robinned/cpe350-astromech-board/README.md

# cpe350-astromech-board
Main control board design for Cal Poly Robotics' astromech, Pascal. Designed by CPE350 Naboo Networks team.
