robinned/cpe350-astromech-board/3d/PCF8575PWR.step

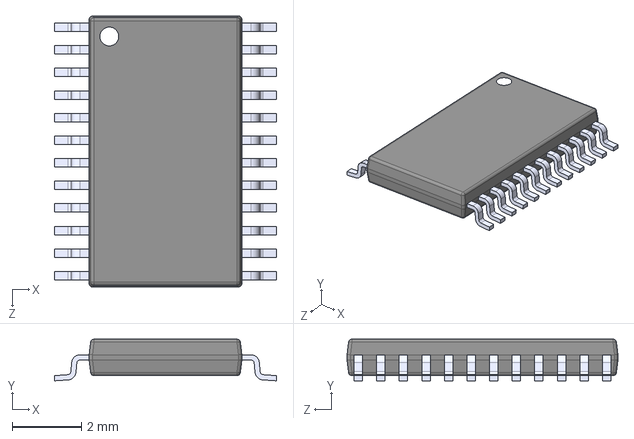
[picture p1: CAD file, 2025-02-07]
3d/PCF8575PWR.step
6.40 x 1.20 x 7.80 mm
