robinned/cpe350-astromech-board/LS7366R/LS7366R.step

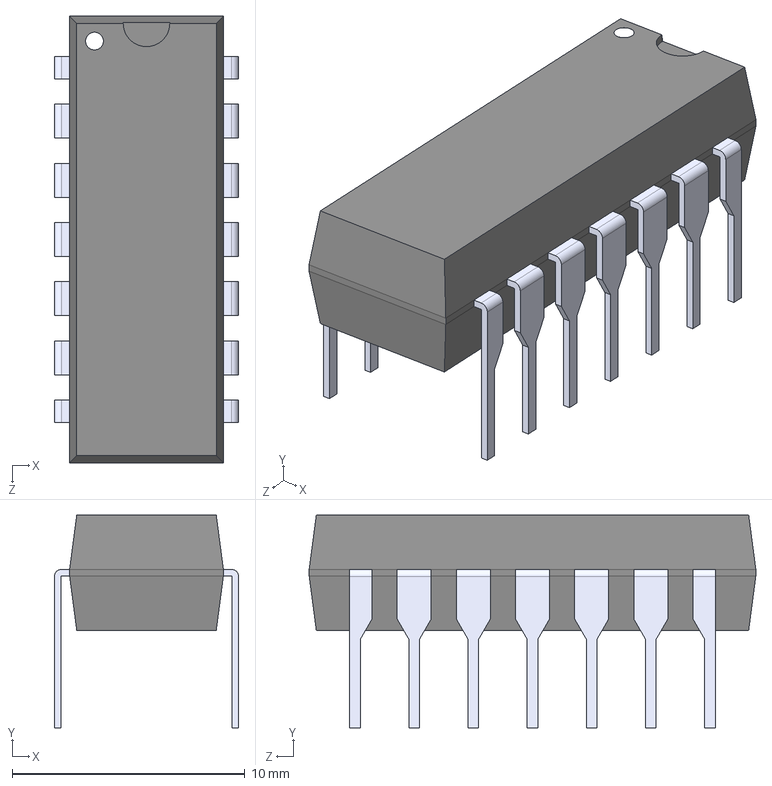
[picture p2: CAD file, 2024-11-14]
LS7366R/LS7366R.step
7.90 x 9.14 x 19.2 mm
