robinned/cpe350-astromech-board/3d/SC16IS752IPW_128.step

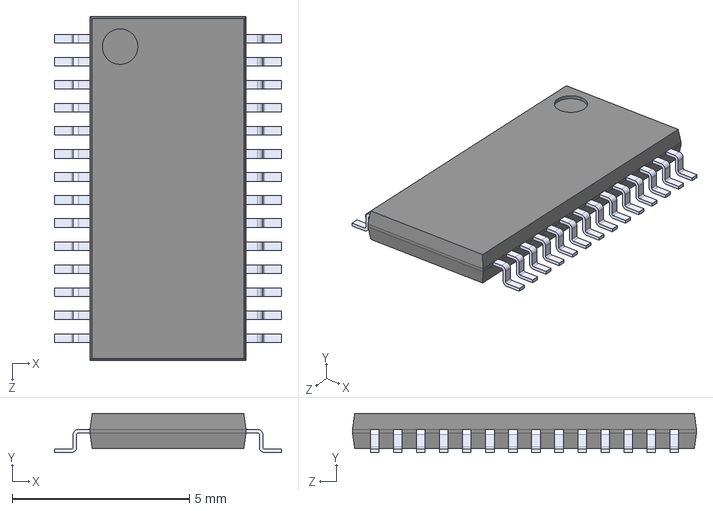
[picture p3: CAD file, 2025-02-04]
3d/SC16IS752IPW_128.step
6.40 x 1.10 x 9.70 mm
