robinned/cpe350-astromech-board/3d/SN74HC14DR.step

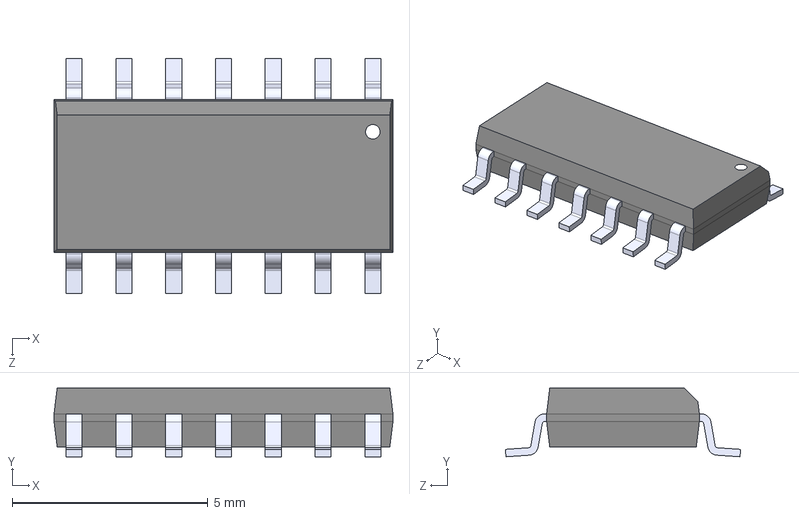
[picture p4: CAD file, 2025-01-31]
3d/SN74HC14DR.step
8.65 x 1.75 x 6.00 mm
