robinned/cpe350-astromech-board/3d/TBL009V-254-16GY-2GY.step

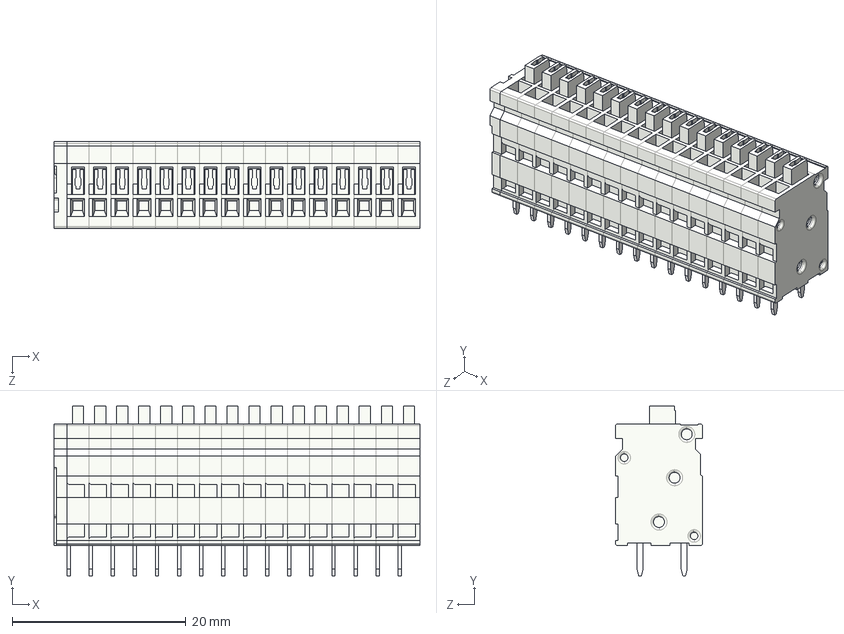
[picture p5: CAD file, 2025-01-31]
3d/TBL009V-254-16GY-2GY.step
42.1 x 19.6 x 10.0 mm
TBL009V-254 - END CAP_Gray
TBL009V-254 - BODY_Gray x 16
TBL009V-254 - PUSH BUTTON_Gray x 16
