robinned/cpe350-astromech-board/3d/691210910005.step

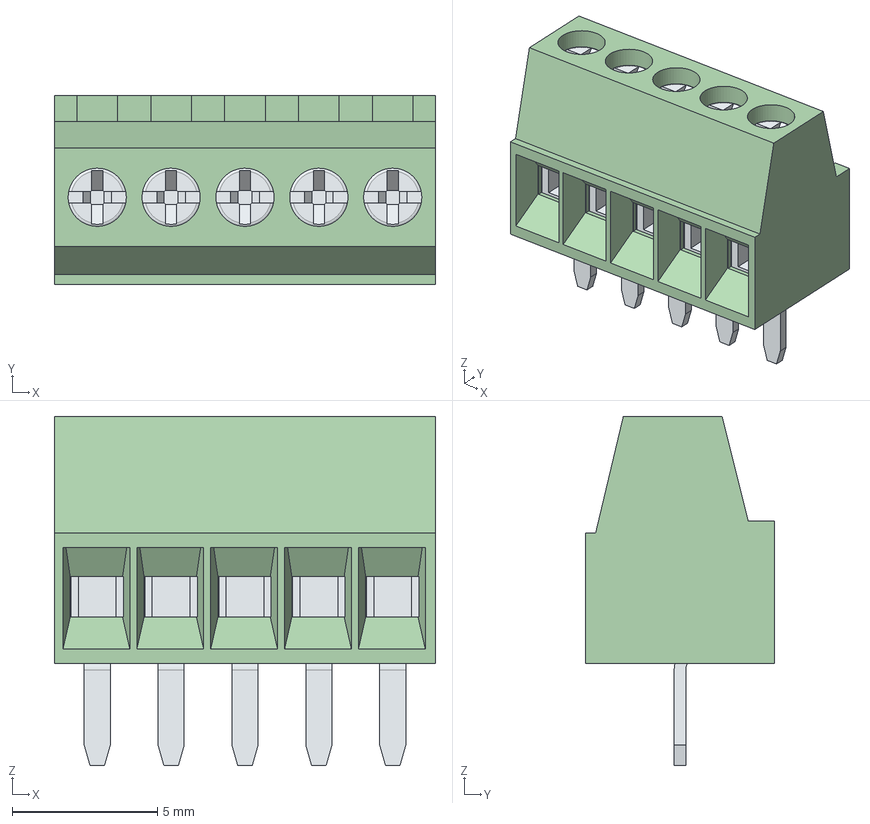
[picture p6: CAD file, 2025-01-31]
3d/691210910005.step
13.1 x 6.50 x 12.0 mm
6912109100xx_CAGE x 5
6912109100xx_PIN x 5
6912109100xx_VIS x 5
