robinned/cpe350-astromech-board/3d/691210910004.step

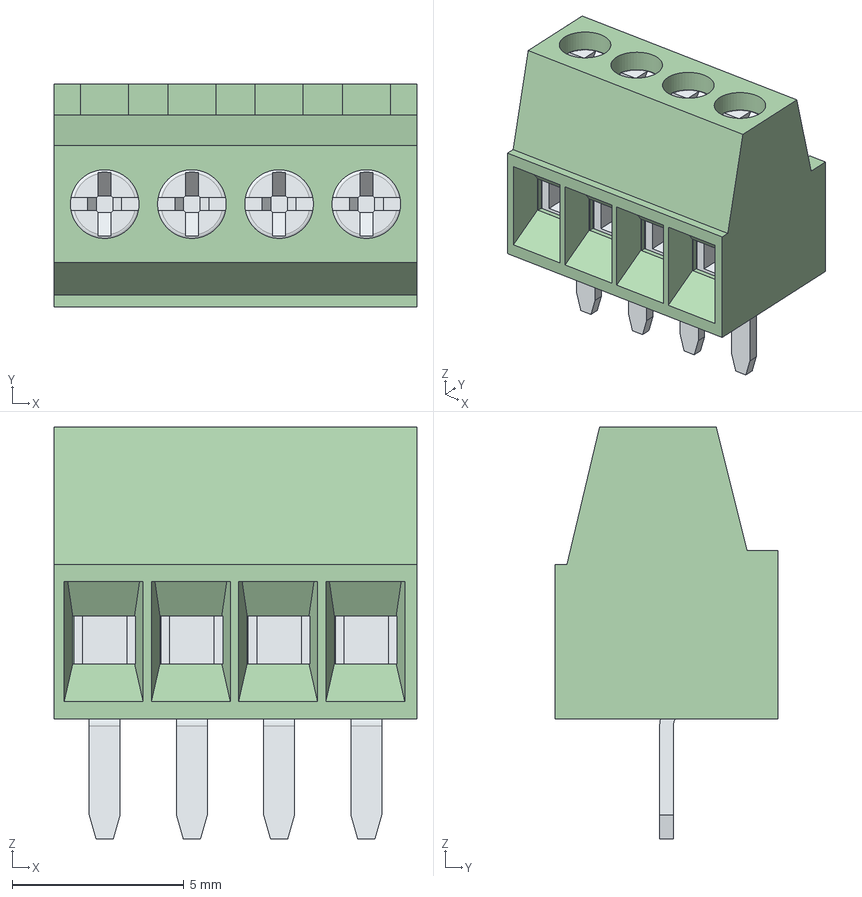
[picture p7: CAD file, 2025-01-31]
3d/691210910004.step
10.6 x 6.50 x 12.0 mm
6912109100xx_CAGE x 4
6912109100xx_PIN x 4
6912109100xx_VIS x 4
