robinned/cpe350-astromech-board/3d/1984617.step

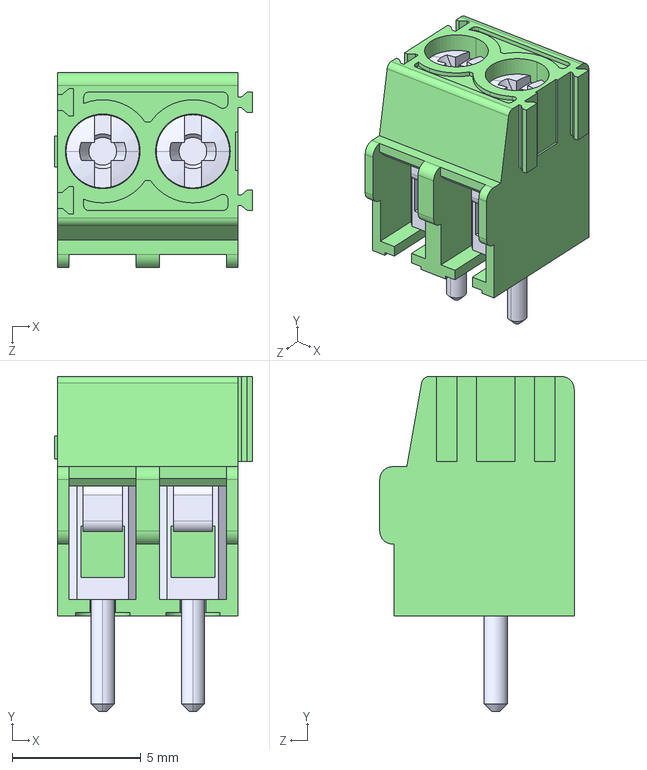
[picture p8: CAD file, 2025-01-31]
3d/1984617.step
7.70 x 13.0 x 7.55 mm
