robinned/cpe350-astromech-board/3d/691210910006.step

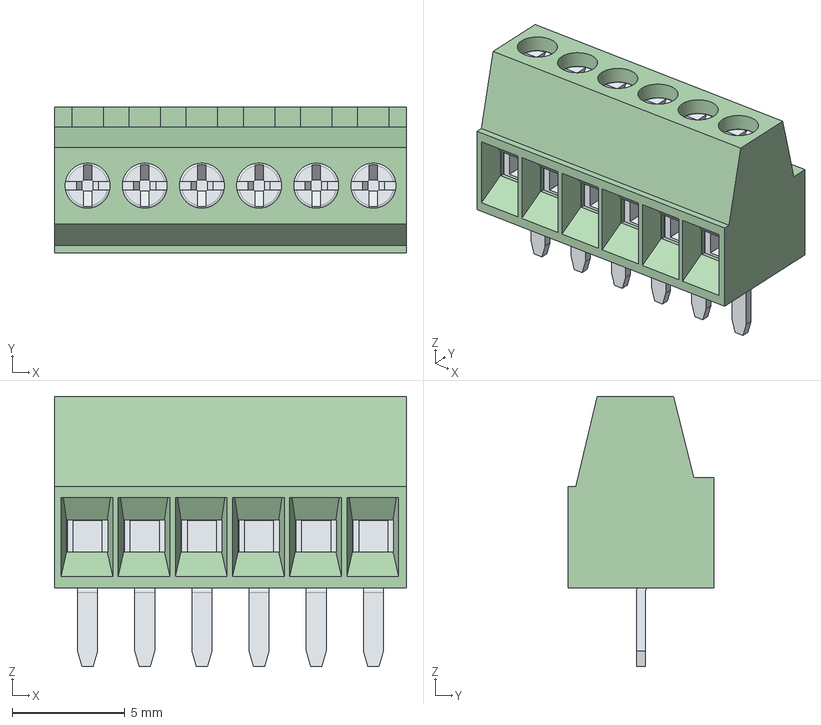
[picture p9: CAD file, 2025-01-31]
3d/691210910006.step
15.6 x 6.50 x 12.0 mm
6912109100xx_CAGE x 6
6912109100xx_PIN x 6
6912109100xx_VIS x 6
