robinned/cpe350-astromech-board/astromech_main_board.kicad_pcb

## KiCad design astromech_main_board.kicad_pcb (2025-02-11)

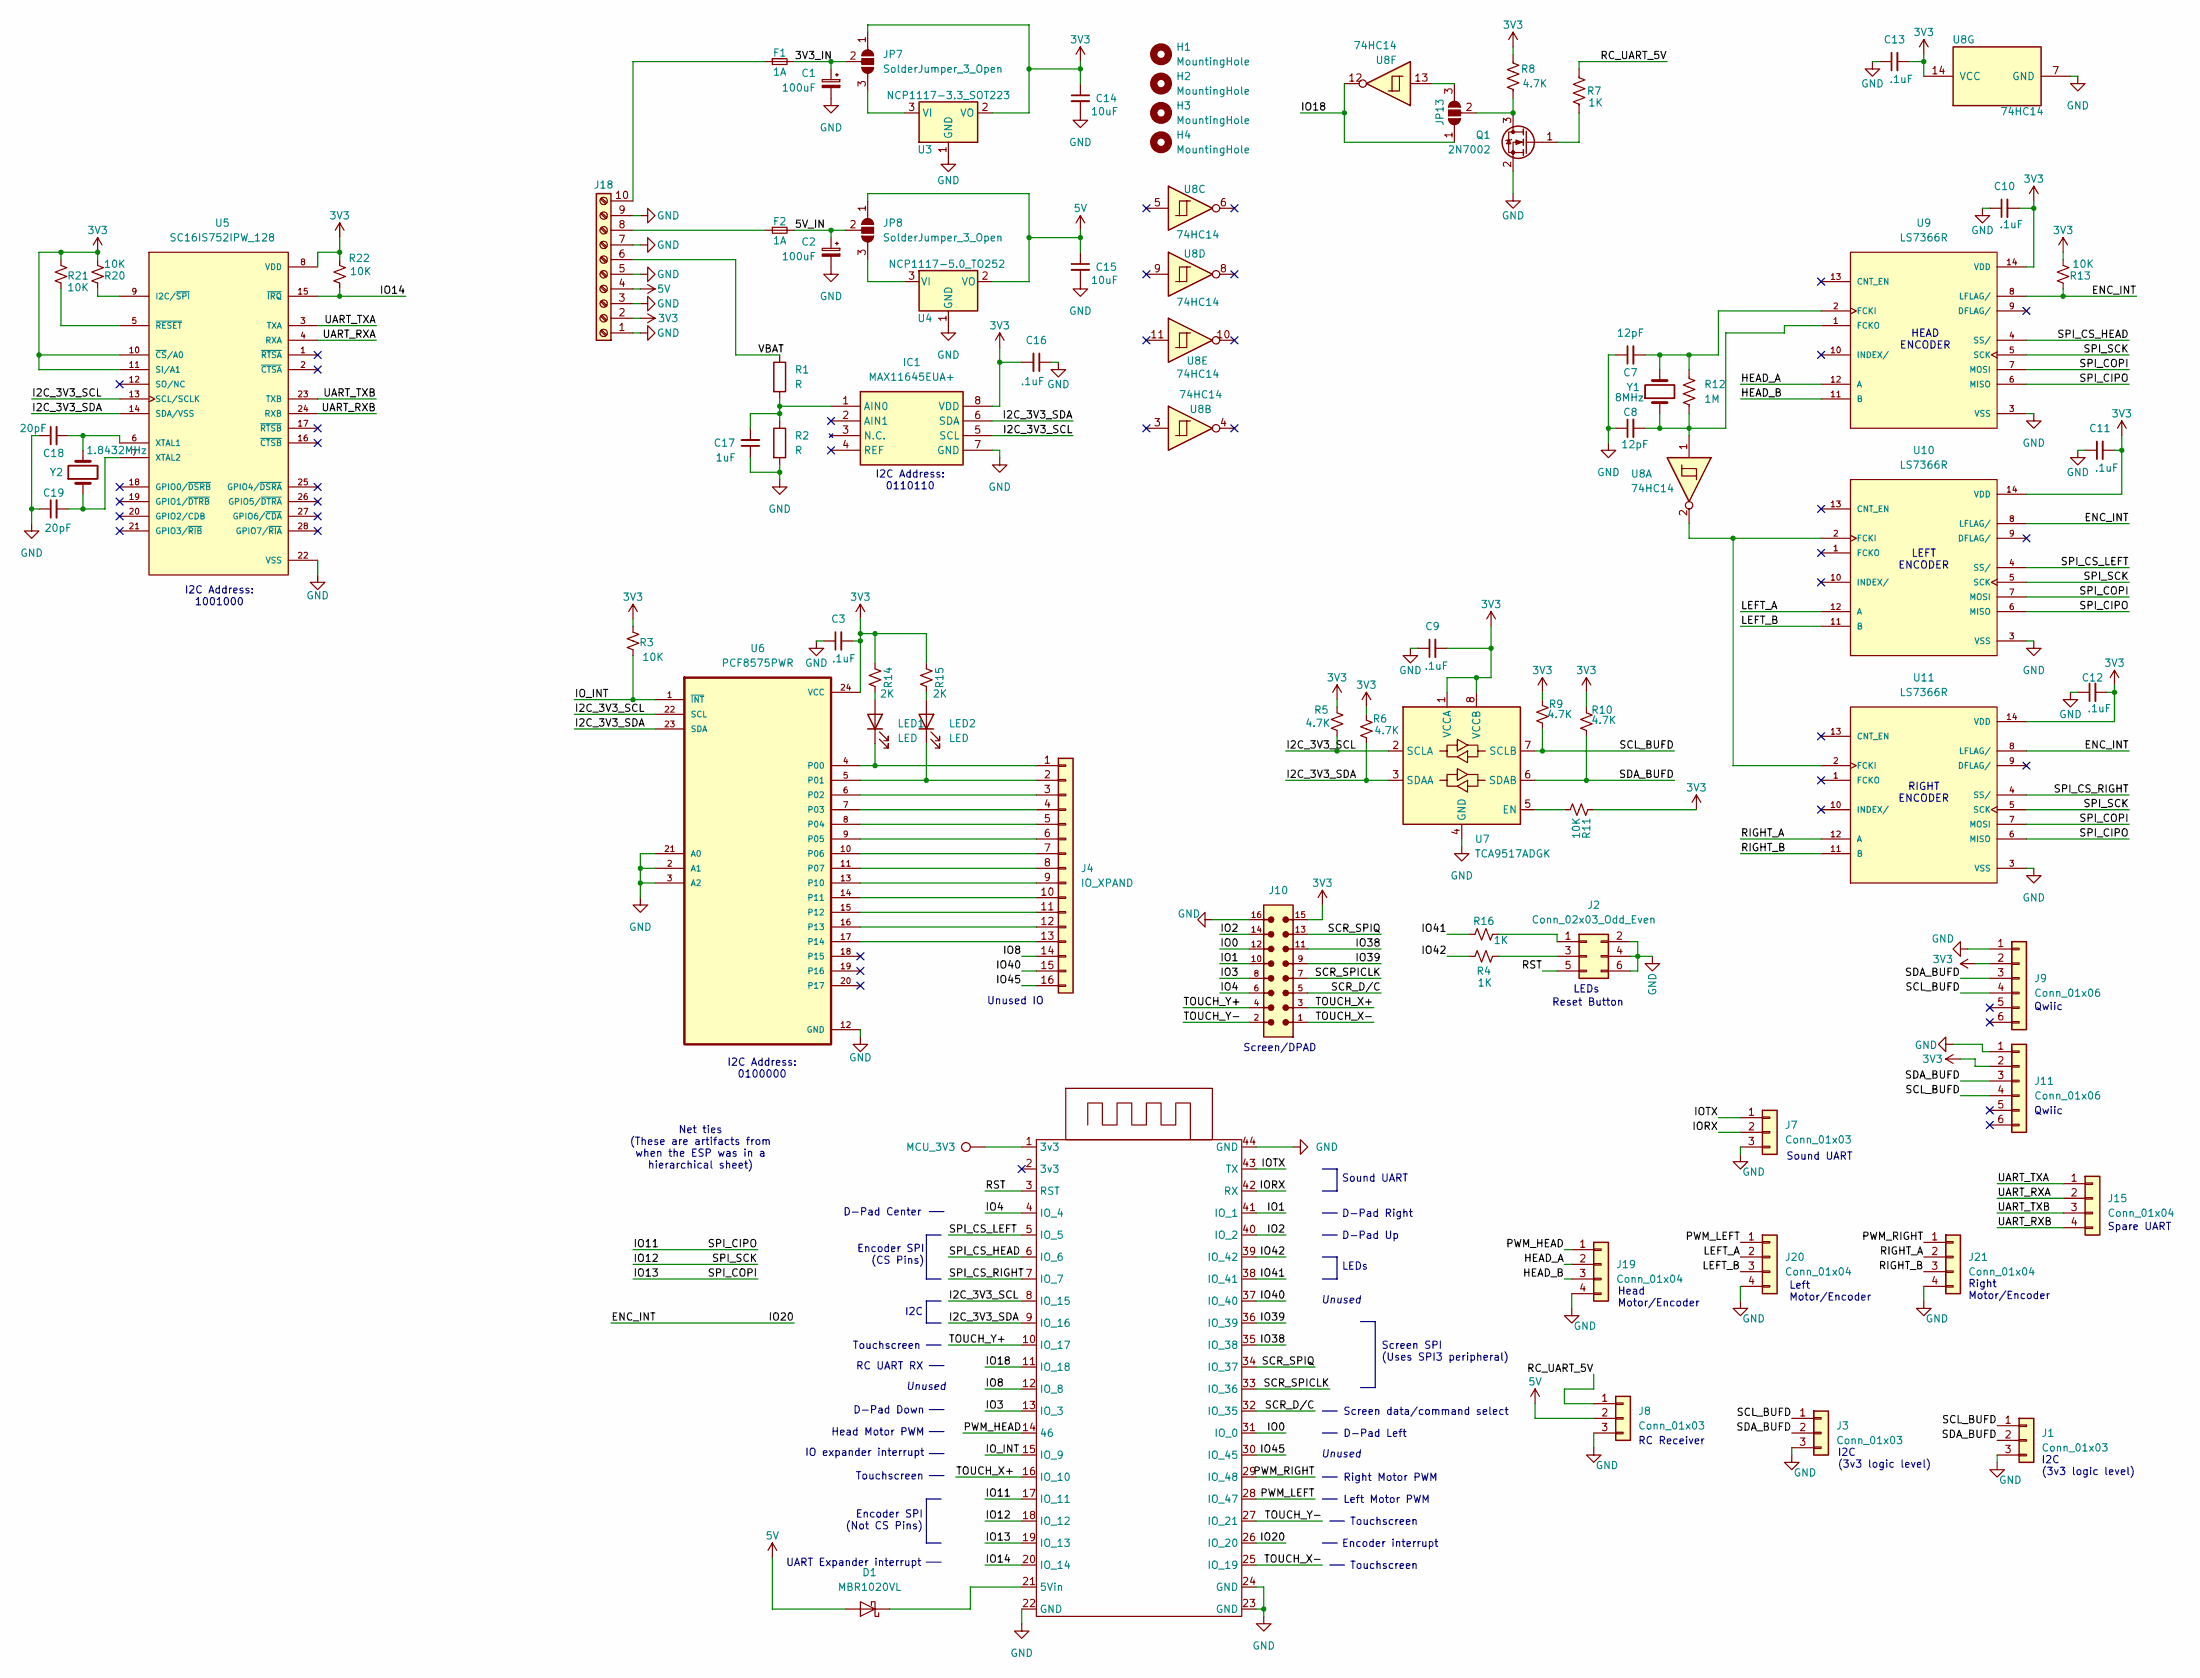
[picture p10: schematic astromech_main_board_v1.0.kicad_sch]

Parts:
C1, C2: 100uF; CP_Elec_6.3x5.8
C3, C9, C10, C11, C12, C13, C16: .1uF; C_1206_3216Metric
C7, C8: 12pF; C_1206_3216Metric
C14, C15: 10uF; C_1206_3216Metric
C17: 1uF; C_1206_3216Metric
C18, C19: 20pF; C_1206_3216Metric
D1: MBR1020VL; D_SOD-123F
F1, F2: 1A; Fuseholder_Blade_Mini_Keystone_3568
H1, H2, H3, H4: MountingHole; MountingHole_3.2mm_M3
IC1: MAX11645EUA+; 21-0036K_MXM; Mouser Part Number 700-MAX11645EUA+
J1, J3, J7: Conn_01x03; 691210910003
J2: Conn_02x03_Odd_Even; PinHeader_2x03_P2.54mm_Vertical
J4: IO_XPAND; CUI_TBL009V-254-16GY-2GY
J8: Conn_01x03; PinSocket_1x03_P2.54mm_Vertical
J9, J11: Conn_01x06; CONN_SM04B-SRSS-TB_JST
J10: 61201621621; PART-NUMBER 61201621621
J15, J19, J20, J21: Conn_01x04; 691210910004
J18: Screw_Terminal_01x10; PHOENIX_1984691
JP7, JP8, JP13: SolderJumper_3_Open; SolderJumper-3_P1.3mm_Open_RoundedPad1.0x1.5mm
LED1, LED2: LED; LED_1206_3216Metric_Pad1.42x1.75mm_HandSolder
MCU_3V3: TestPoint; TestPoint_Pad_D1.0mm
Q1: 2N7002; SOT-23
R1, R2: R; R_1206_3216Metric
R3, R11, R13, R20, R21, R22: 10K; R_1206_3216Metric
R4, R7, R16: 1K; R_1206_3216Metric
R5, R6, R8, R9, R10: 4.7K; R_1206_3216Metric
R12: 1M; R_1206_3216Metric
R14, R15: 2K; R_1206_3216Metric
U3: NCP1117-3.3_SOT223; SOT-223-3_TabPin2
U4: NCP1117-5.0_TO252; TO-252-2
U5: SC16IS752IPW_128; SOP65P640X110-28N; PARTREV 9
U6: PCF8575PWR; SOP65P640X120-24N
U7: TCA9517ADGK; VSSOP-8_3x3mm_P0.65mm
U8: 74HC14; SOIC127P600X175-14N
U9, U10, U11: LS7366R; SOIC14_LS7366R_LSI; PARTREV June 2014
U13: YD-ESP32-S3
Y1: 8MHz; Crystal_SMD_Abracon_ABM3-2Pin_5.0x3.2mm
Y2: 1.8432MHz; Crystal_HC49-U_Vertical

Connections:
3V3: C3.2, C9.2, C10.2, C11.2, C12.2, C13.2, C14.1, C16.2, IC1.8 (VDD), J9.2, J10.15, J11.2, J18.2, JP7.1 (A), R3.1, R5.1, R6.1, R8.1, R9.1, R10.1, R11.1, R13.1, R14.1, R15.1, R20.1, R21.1, R22.2, U3.2 (VO), U5.8 (VDD), U5.10 (~CS/A0), U5.11 (SI/A1), U6.24 (VCC), U7.1 (VCCA), U7.8 (VCCB), U8.14 (VCC), U9.14 (VDD), U10.14 (VDD), U11.14 (VDD)
5V: C15.1, D1.2 (A), J8.2, J18.4, JP8.1 (A), U4.2 (VO)
/3V3_IN: C1.1, F1.2, JP7.2 (C)
/5V_IN: C2.1, F2.2, JP8.2 (C)
/ENC_INT: R13.2, U9.8 (LFLAG/), U10.8 (LFLAG/), U11.8 (LFLAG/), U13.26 (IO_20)
/HEAD_A: J19.2, U9.12 (A)
/HEAD_B: J19.3, U9.11 (B)
/I2C_3V3_SCL: IC1.5 (SCL), R5.2, U5.13 (SCL/SCLK), U6.22 (SCL), U7.2 (SCLA), U13.8 (IO_15)
/I2C_3V3_SDA: IC1.6 (SDA), R6.2, U5.14 (SDA/VSS), U6.23 (SDA), U7.3 (SDAA), U13.9 (IO_16)
/IO0: J10.12, U13.31 (IO_0)
/IO1: J10.10, U13.41 (IO_1)
/IO2: J10.14, U13.40 (IO_2)
/IO3: J10.8, U13.13 (IO_3)
/IO4: J10.6, U13.4 (IO_4)
/IO8: J4.14, U13.12 (IO_8)
/IO11: U9.6 (MISO), U10.6 (MISO), U11.6 (MISO), U13.17 (IO_11)
/IO12: U9.5 (SCK), U10.5 (SCK), U11.5 (SCK), U13.18 (IO_12)
/IO13: U9.7 (MOSI), U10.7 (MOSI), U11.7 (MOSI), U13.19 (IO_13)
/IO14: R22.1, U5.15 (~IRQ), U13.20 (IO_14)
/IO18: JP13.1 (A), U8.12, U13.11 (IO_18)
/IO38: J10.11, U13.35 (IO_38)
/IO39: J10.9, U13.36 (IO_39)
/IO40: J4.15, U13.37 (IO_40)
/IO41: R16.1, U13.38 (IO_41)
/IO42: R4.1, U13.39 (IO_42)
/IO45: J4.16, U13.30 (IO_45)
/IORX: J7.2, U13.42 (RX)
/IOTX: J7.1, U13.43 (TX)
/IO_INT: R3.2, U6.1 (~INT), U13.15 (IO_9)
/LEFT_A: J20.2, U10.12 (A)
/LEFT_B: J20.3, U10.11 (B)
/PWM_HEAD: J19.1, U13.14 (46)
/PWM_LEFT: J20.1, U13.28 (IO_47)
/PWM_RIGHT: J21.1, U13.29 (IO_48)
/RC_UART_5V: J8.1, R7.1
/RIGHT_A: J21.2, U11.12 (A)
/RIGHT_B: J21.3, U11.11 (B)
/RST: J2.5, U13.3 (RST)
/SCL_BUFD: J1.1, J3.1, J9.4, J11.4, R9.2, U7.7 (SCLB)
/SCR_D/C: J10.5, U13.32 (IO_35)
/SCR_SPICLK: J10.7, U13.33 (IO_36)
/SCR_SPIQ: J10.13, U13.34 (IO_37)
/SDA_BUFD: J1.2, J3.2, J9.3, J11.3, R10.2, U7.6 (SDAB)
/SPI_CS_HEAD: U9.4 (SS/), U13.6 (IO_6)
/SPI_CS_LEFT: U10.4 (SS/), U13.5 (IO_5)
/SPI_CS_RIGHT: U11.4 (SS/), U13.7 (IO_7)
/TOUCH_X+: J10.3, U13.16 (IO_10)
/TOUCH_X-: J10.1, U13.25 (IO_19)
/TOUCH_Y+: J10.4, U13.10 (IO_17)
/TOUCH_Y-: J10.2, U13.27 (IO_21)
/UART_RXA: J15.2, U5.4 (RXA)
/UART_RXB: J15.4, U5.24 (RXB)
/UART_TXA: J15.1, U5.3 (TXA)
/UART_TXB: J15.3, U5.23 (TXB)
/VBAT: J18.6, R1.1
GND: C1.2, C2.2, C3.1, C7.1, C8.1, C9.1, C10.1, C11.1, C12.1, C13.1, C14.2, C15.2, C16.1, C17.1, C18.1, C19.1, IC1.7 (GND), J1.3, J2.2, J2.4, J2.6, J3.3, J7.3, J8.3, J9.1, J10.16, J11.1, J18.1, J18.3, J18.5, J18.7, J18.9, J19.4, J20.4, J21.4, Q1.2 (S), R2.2, U3.1 (GND), U4.1 (GND), U5.22 (VSS), U6.2 (A1), U6.3 (A2), U6.12 (GND), U6.21 (A0), U7.4 (GND), U8.7 (GND), U9.3 (VSS), U10.3 (VSS), U11.3 (VSS), U13.22 (GND), U13.23 (GND), U13.24 (GND), U13.44 (GND)
unnamed: D1.1 (K), U13.21 (5Vin)
unnamed: C17.2, IC1.1 (AIN0), R1.2, R2.1
unnamed: J2.1, R16.2
unnamed: J2.3, R4.2
unnamed: J4.1, LED1.1 (K), U6.4 (P00)
unnamed: J4.2, LED2.1 (K), U6.5 (P01)
unnamed: J4.3, U6.6 (P02)
unnamed: J4.4, U6.7 (P03)
unnamed: J4.5, U6.8 (P04)
unnamed: J4.6, U6.9 (P05)
unnamed: J4.7, U6.10 (P06)
unnamed: J4.8, U6.11 (P07)
unnamed: J4.9, U6.13 (P10)
unnamed: J4.10, U6.14 (P11)
unnamed: J4.11, U6.15 (P12)
unnamed: J4.12, U6.16 (P13)
unnamed: J4.13, U6.17 (P14)
unnamed: F2.1, J18.8
unnamed: F1.1, J18.10
unnamed: JP7.3 (B), U3.3 (VI)
unnamed: JP8.3 (B), U4.3 (VI)
unnamed: JP13.3 (B), U8.13
unnamed: JP13.2 (C), Q1.3 (D), R8.2
unnamed: LED1.2 (A), R14.2
unnamed: LED2.2 (A), R15.2
unnamed: MCU_3V3.1, U13.1 (3v3)
unnamed: Q1.1 (G), R7.2
unnamed: R20.2, U5.9 (I2C/~SPI)
unnamed: C18.2, U5.6 (XTAL1), Y2.2
unnamed: C19.2, U5.7 (XTAL2), Y2.1
unnamed: R21.2, U5.5 (~RESET)
unnamed: R11.2, U7.5 (EN)
unnamed: C7.2, R12.1, U9.2 (FCKI), Y1.2
unnamed: C8.2, R12.2, U8.1, U9.1 (FCKO), Y1.1
unnamed: U8.2, U10.2 (FCKI), U11.2 (FCKI)

Notes on the sheet:
Head Motor PWM
D-Pad Right
Reset Button
Net ties (These are artifacts from when the ESP was in a hierarchical sheet)
D-Pad Left
Screen SPI (Uses SPI3 peripheral)
I2C
Qwiic
RC UART RX
UART Expander interrupt
Right Motor/Encoder
Touchscreen
Unused IO
Encoder SPI (Not CS Pins)
Encoder interrupt
Encoder SPI (CS Pins)
RIGHT ENCODER
Right Motor PWM
I2C (3v3 logic level)
LEDs
IO expander interrupt
I2C Address: 0110110
Sound UART
LEFT ENCODER
D-Pad Center
Unused
D-Pad Down
HEAD ENCODER
Left Motor PWM
Screen/DPAD
Spare UART
Screen data/command select
Head Motor/Encoder
D-Pad Up
Left Motor/Encoder
I2C Address: 1001000
I2C Address: 0100000
RC Receiver

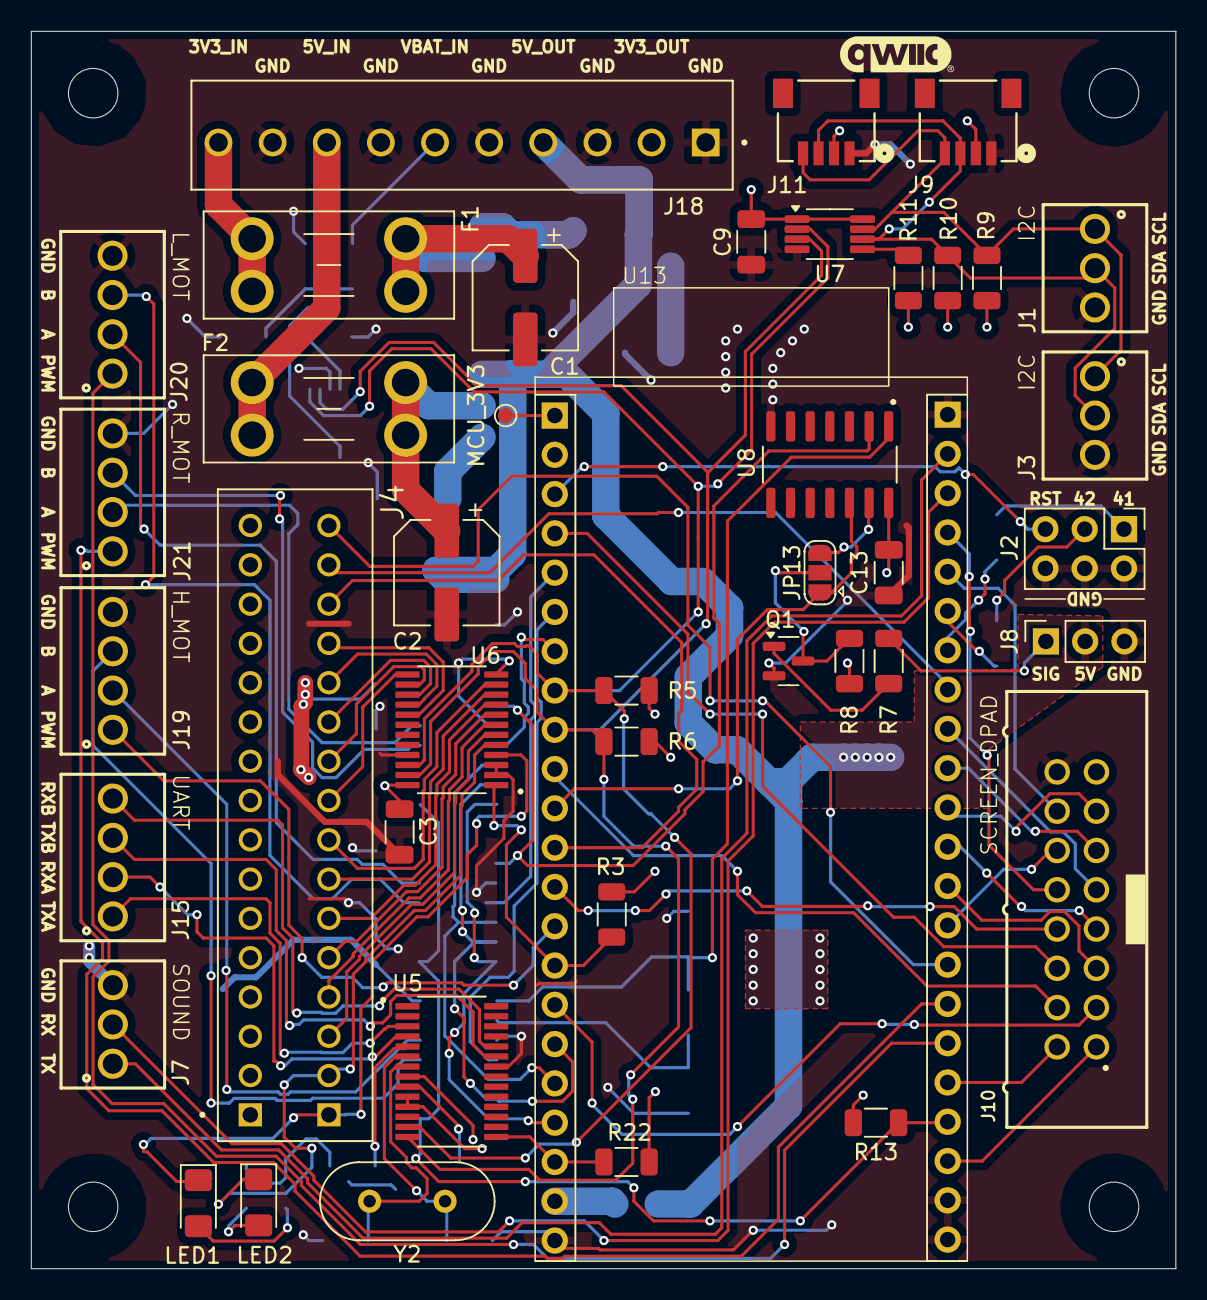
[picture p11: board astromech_main_board.kicad_pcb from above]

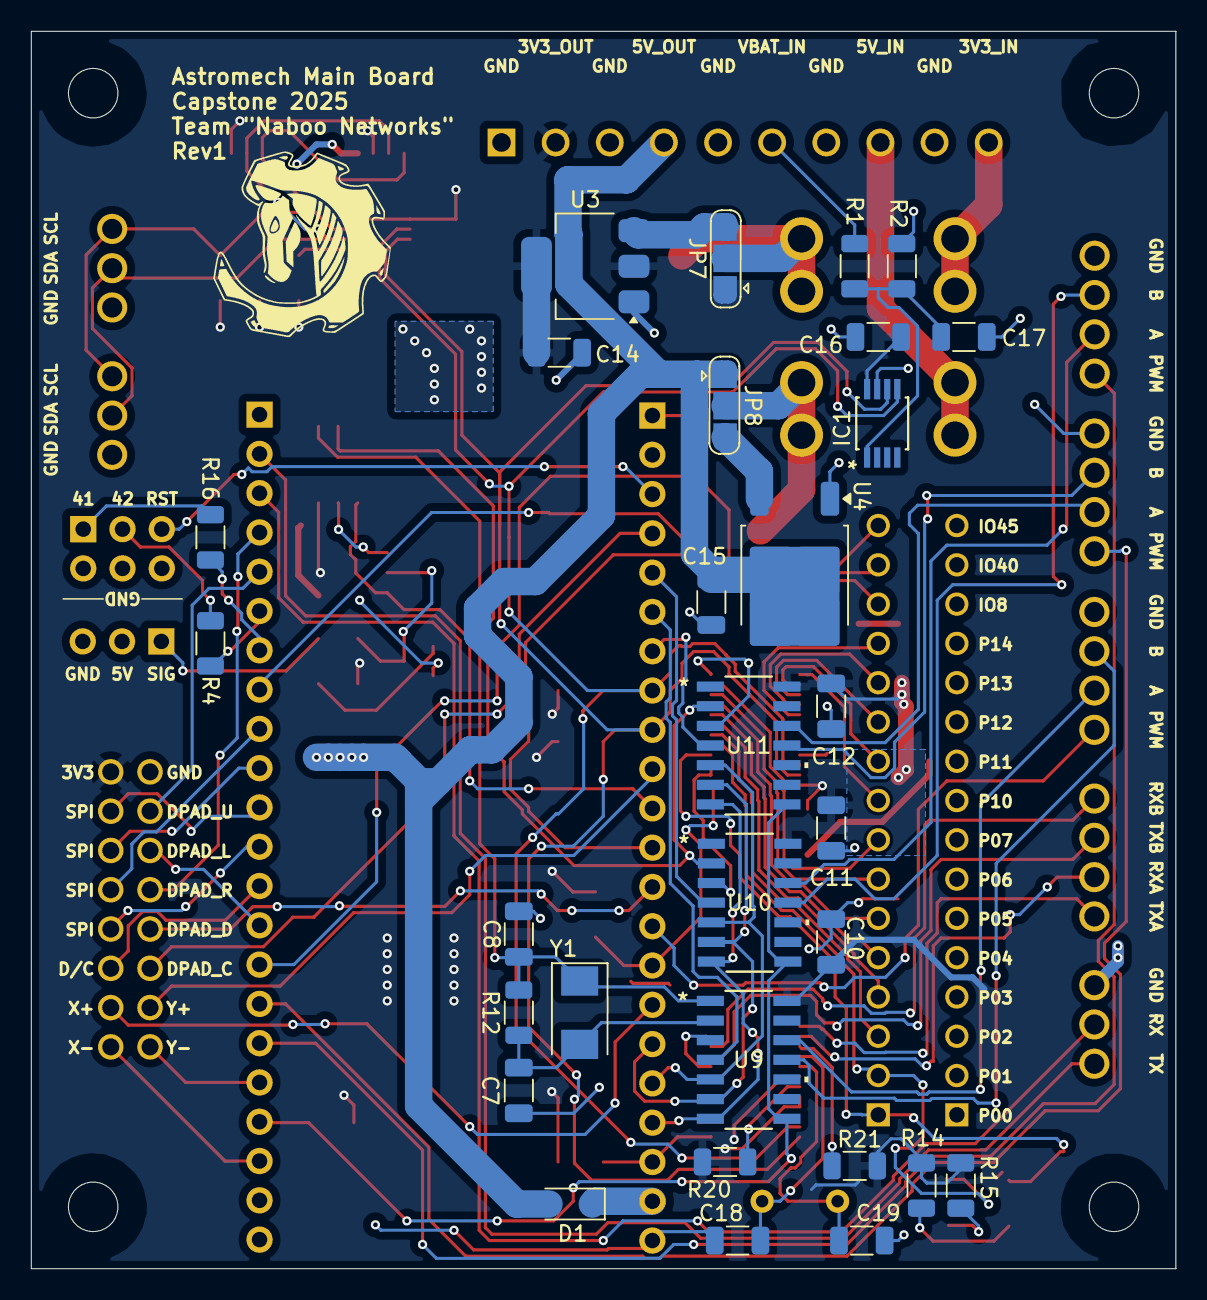
[picture p12: board astromech_main_board.kicad_pcb from below]

Board: 2 copper layers, 74.0 x 80.0 mm, 76 parts (30 on the bottom side), 91 nets.
