robinned/cpe350-astromech-board/(commit log)

2024-10-04 project initialized
    [astromech_main_board.kicad_pcb, astromech_main_board.kicad_sch]
2024-10-17 added ESP board
    [astromech_main_board.kicad_sch]
2024-10-28 added blocks
    [astromech_main_board.kicad_sch]
2024-10-28 added yd-esp32-s3
    [ESP32.kicad_sch]
2024-10-28 wire GND
    Added some wires and GND
    [power_protection.kicad_sch]
2024-10-28 first try
    [ESP32.kicad_sch, astromech_main_board.kicad_sch, io_expander.kicad_sch, io_protection.kicad_sch, power_protection.kicad_sch, voltage_monitoring.kicad_sch]
2024-10-28 added labels to io_prot
    [io_protection.kicad_sch]
2024-11-08 Updated Power Protection
    Added:
    - Solder Jumper
    - Two Input Voltages 3.3 and 5.0
    - Voltage Regulators
    [power_protection.kicad_sch, voltage_monitoring.kicad_sch]
2024-11-10 voltage monitoring schematic done
2024-11-10 added i2c to io_protection
    [ESP32.kicad_sch, io_protection.kicad_sch, power_protection.kicad_sch, voltage_monitoring.kicad_sch]
2024-11-10 added i2c buffer + wired a0 to gnd
    [io_protection.kicad_sch]
2024-11-10 added all block interface pins
    [ESP32.kicad_sch, astromech_main_board.kicad_sch, io_expander.kicad_sch, power_protection.kicad_sch, voltage_monitoring.kicad_sch]
2024-11-13 Updated IO Expander
    Created bus input (SCL, SDA, INT) and bus output (PO{15:0}).
    Using the TCA9554 Low Voltage 8-Bit for I2C communication. The output of PO is tied to the VCC input and each address is configurable with solder jumpers being tied to either VCC or GND.
    [io_expander.kicad_sch]
2024-11-13 added hw encoder
    [LS7366R.step, astromech_main_board.kicad_sch, hw_encoder.kicad_sch]
2024-11-14 ESP32 mostly done
    [ESP32.kicad_sch]
2024-12-20 moved power protection
    [ESP32.kicad_sch, astromech_main_board.kicad_sch, io_expander.kicad_sch, power_protection.kicad_sch, voltage_monitoring.kicad_sch]
2024-12-20 moved voltage monitoring
    [astromech_main_board.kicad_sch, voltage_monitoring.kicad_sch]
2024-12-20 moved io expander
    [astromech_main_board.kicad_sch]
2024-12-29 moved encoder
    [astromech_main_board.kicad_sch]
2025-01-09 Updated MCU
    [astromech_main_board.kicad_sch]
2025-01-17 consolidated schematic
    [astromech_main_board.kicad_sch]
2025-01-21 add qwiic connectors
    [astromech_main_board.kicad_pcb, astromech_main_board.kicad_sch]
2025-01-22 added missing files
    [MCU.kicad_sch, inverter.kicad_sch, level_converter.kicad_sch]
2025-01-23 Connections 98%
    - Pushing Before Deleting Connection
    - Was able to connect all the labels except for ENC_INT for IO20. When highlighting connections, it is not showing up. :(
    [astromech_main_board.kicad_sch]
2025-01-23 Connections deleted, ENC_INT works
    - Pushing before deleting MCU and fitting ESP to sheet
    - Deleted all the connections for root
    - ENC_INT now highlights for some reason??
    [astromech_main_board.kicad_sch]
2025-01-23 Resized Sheet in root
    - Will delete MCU tomorrow...
    - Check in with Eva
    [astromech_main_board.kicad_sch]
2025-01-24 Removed Block
    - Everything should be on page
    [astromech_main_board.kicad_sch]
2025-01-31 some board done
    [1984617.step, 691210910004.step, 691210910005.step, 691210910006.step, SN74HC14DR.step, TBL009V-254-16GY-2GY.step, astromech_main_board.kicad_pcb, astromech_main_board.kicad_sch]
2025-02-01 added 8mil trace/space constraints to board
    [astromech_main_board.kicad_pcb]
2025-02-03 added UART chip
    [astromech_main_board.kicad_pcb, astromech_main_board.kicad_sch]
2025-02-03 started routing
    [astromech_main_board.kicad_pcb]
2025-02-03 made encoders 3v3
    [astromech_main_board.kicad_sch]
2025-02-04 layout mostly done
    [astromech_main_board.kicad_pcb, astromech_main_board.kicad_sch]
2025-02-04 main routing done
    [SC16IS752IPW_128.step, astromech_main_board.kicad_pcb, astromech_main_board.kicad_sch]
2025-02-04 3v3 routed
    [astromech_main_board.kicad_pcb, astromech_main_board.kicad_sch]
2025-02-04 changed board setup to 8mil trace/spacing
    [astromech_main_board.kicad_pcb]
2025-02-04 renamed nets
    [astromech_main_board.kicad_pcb, astromech_main_board.kicad_sch]
2025-02-06 compact layout start
    [astromech_main_board.kicad_pcb]
2025-02-07 implemented suggestions
    [PCF8575PWR.step, astromech_main_board.kicad_pcb, astromech_main_board.kicad_sch]
2025-02-07 added values, 2N7002, and updated unused pins
    [astromech_main_board.kicad_pcb, astromech_main_board.kicad_sch]
2025-02-07 switch qwiic pinout order
    [astromech_main_board.kicad_pcb, astromech_main_board.kicad_sch]
2025-02-08 schematic updates
    [astromech_main_board.kicad_pcb, astromech_main_board.kicad_sch]
2025-02-08 new layout
    [astromech_main_board.kicad_pcb, astromech_main_board.kicad_sch]
2025-02-08 new layout done
    [astromech_main_board.kicad_pcb, astromech_main_board.kicad_sch]
2025-02-09 somewhat routed
    [astromech_main_board.kicad_pcb]
2025-02-09 finished routing
    [astromech_main_board.kicad_pcb]
2025-02-09 switched motor terminal positions, adjusted silkscreen and routing
    [astromech_main_board.kicad_pcb]
2025-02-09 reordered terminal blocks
    [astromech_main_board.kicad_pcb]
2025-02-11 added silkscreen
    [astromech_main_board.kicad_pcb]
2025-02-11 fixed pinout and some silkscreen labels
    [astromech_main_board.kicad_pcb, astromech_main_board.kicad_sch]
2025-02-11 added keepout near mounting holes
    [astromech_main_board.kicad_pcb]
2025-02-11 added diode
    [astromech_main_board.kicad_pcb, astromech_main_board.kicad_sch]
2025-02-11 updated part values
    [astromech_main_board.kicad_sch]
2025-02-15 added version 1.0 of board
    [astromech_main_board_v1.0.kicad_sch]
